jayheiland/CE_Senior_Project/schematics/HIGH_PASS_ACRYLLIC.pdf

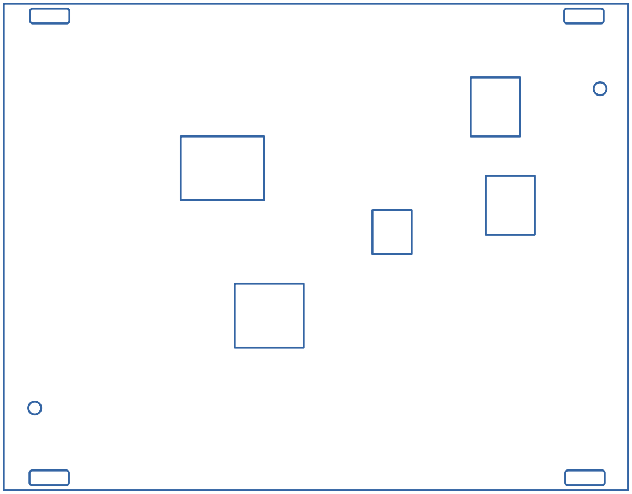
[picture p20: figure]
