jayheiland/CE_Senior_Project/schematics/PCB_ACRYLLIC.pdf

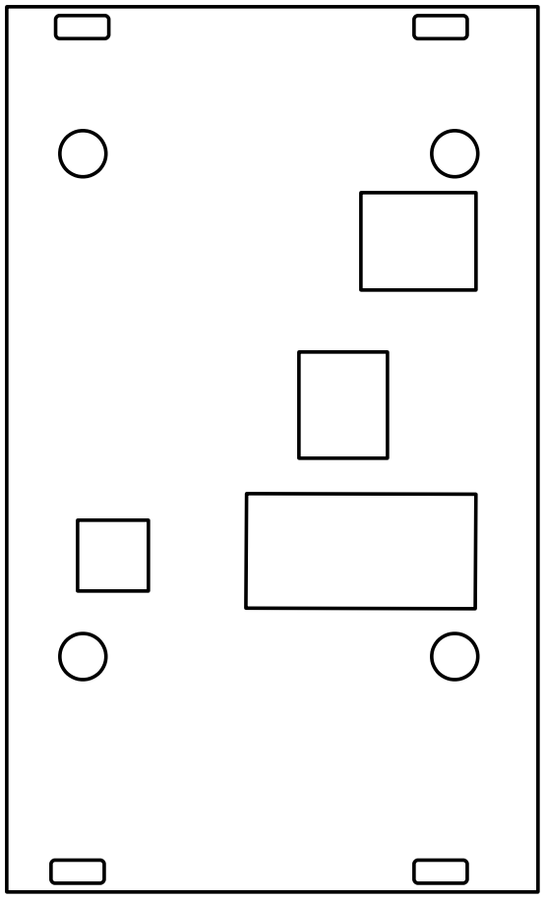
[picture p21: figure]
