jayheiland/CE_Senior_Project/docs/spring 2019 docs/IMG_0136.jpg

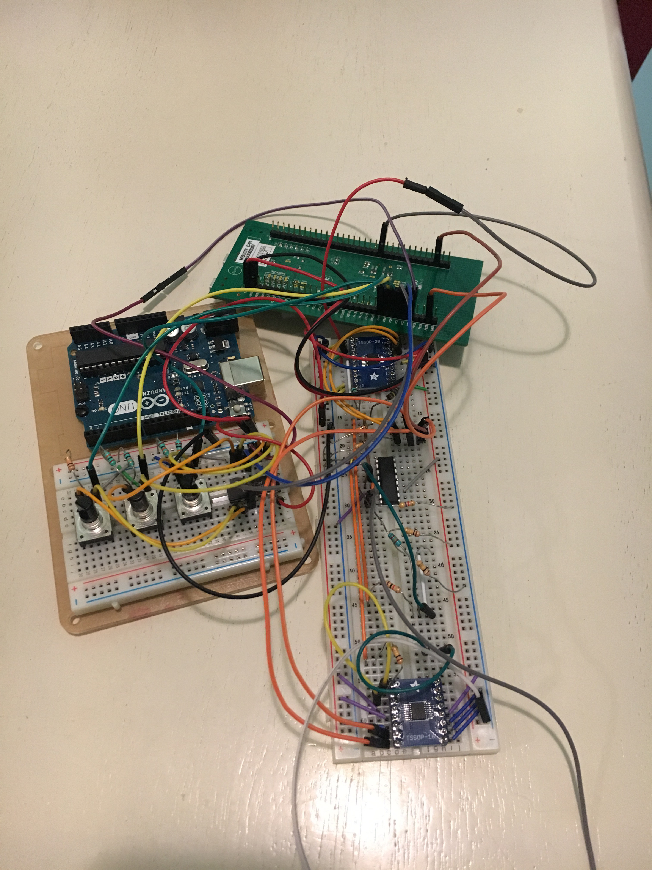
docs/spring 2019 docs/IMG_0136.jpg
