jayheiland/CE_Senior_Project/docs/spring 2019 docs/schematic.PNG

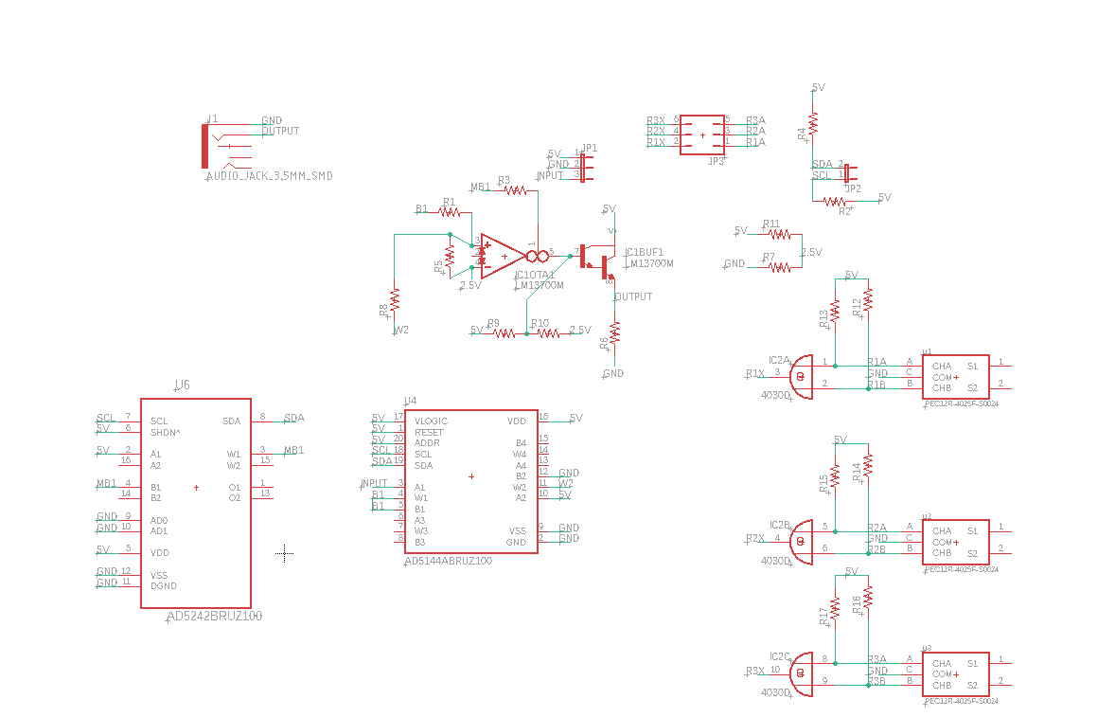
docs/spring 2019 docs/schematic.PNG
