jayheiland/CE_Senior_Project/docs/spring 2019 docs/triangleToSine.png

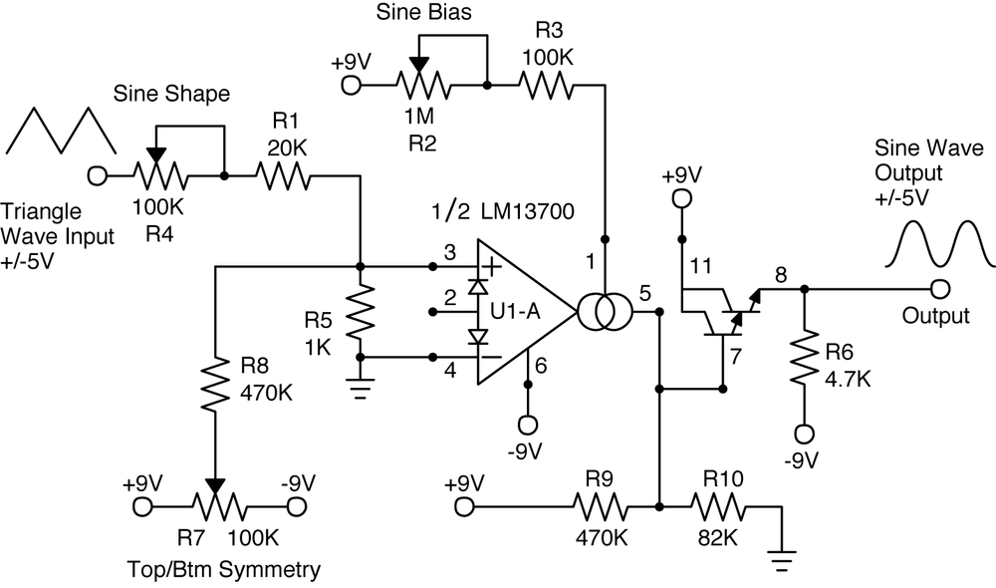
docs/spring 2019 docs/triangleToSine.png
