jayheiland/CE_Senior_Project/app src/todo.txt

To-do:

Sliders in GUI
Test if the serial error is a constant problem, or if it can be fixed by resetting the STM
reduce read timer time
try removing the update modules sleep

usage note: .cancel read_timer before calling restart_read_timer
