jayheiland/CE_Senior_Project/docs/spring 2019 docs/Board.pdf

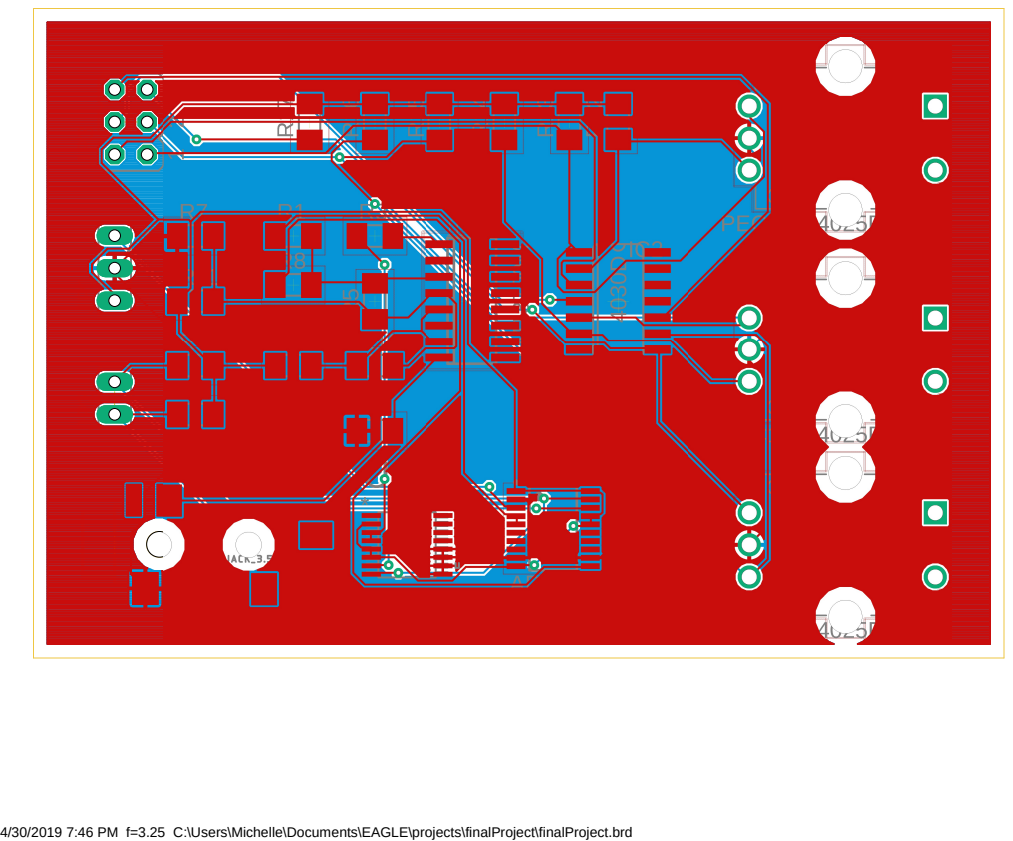
[picture p25: page 1]
PEC12R-4025F-S0024

4/30/2019 7:46 PM f=3.25 C:\Users\Michelle\Documents\EAGLE\projects\finalProject\finalProject.brd
