jayheiland/CE_Senior_Project/schematics/VCO.brd

## EAGLE design schematics/VCO.brd (2020-01-23)

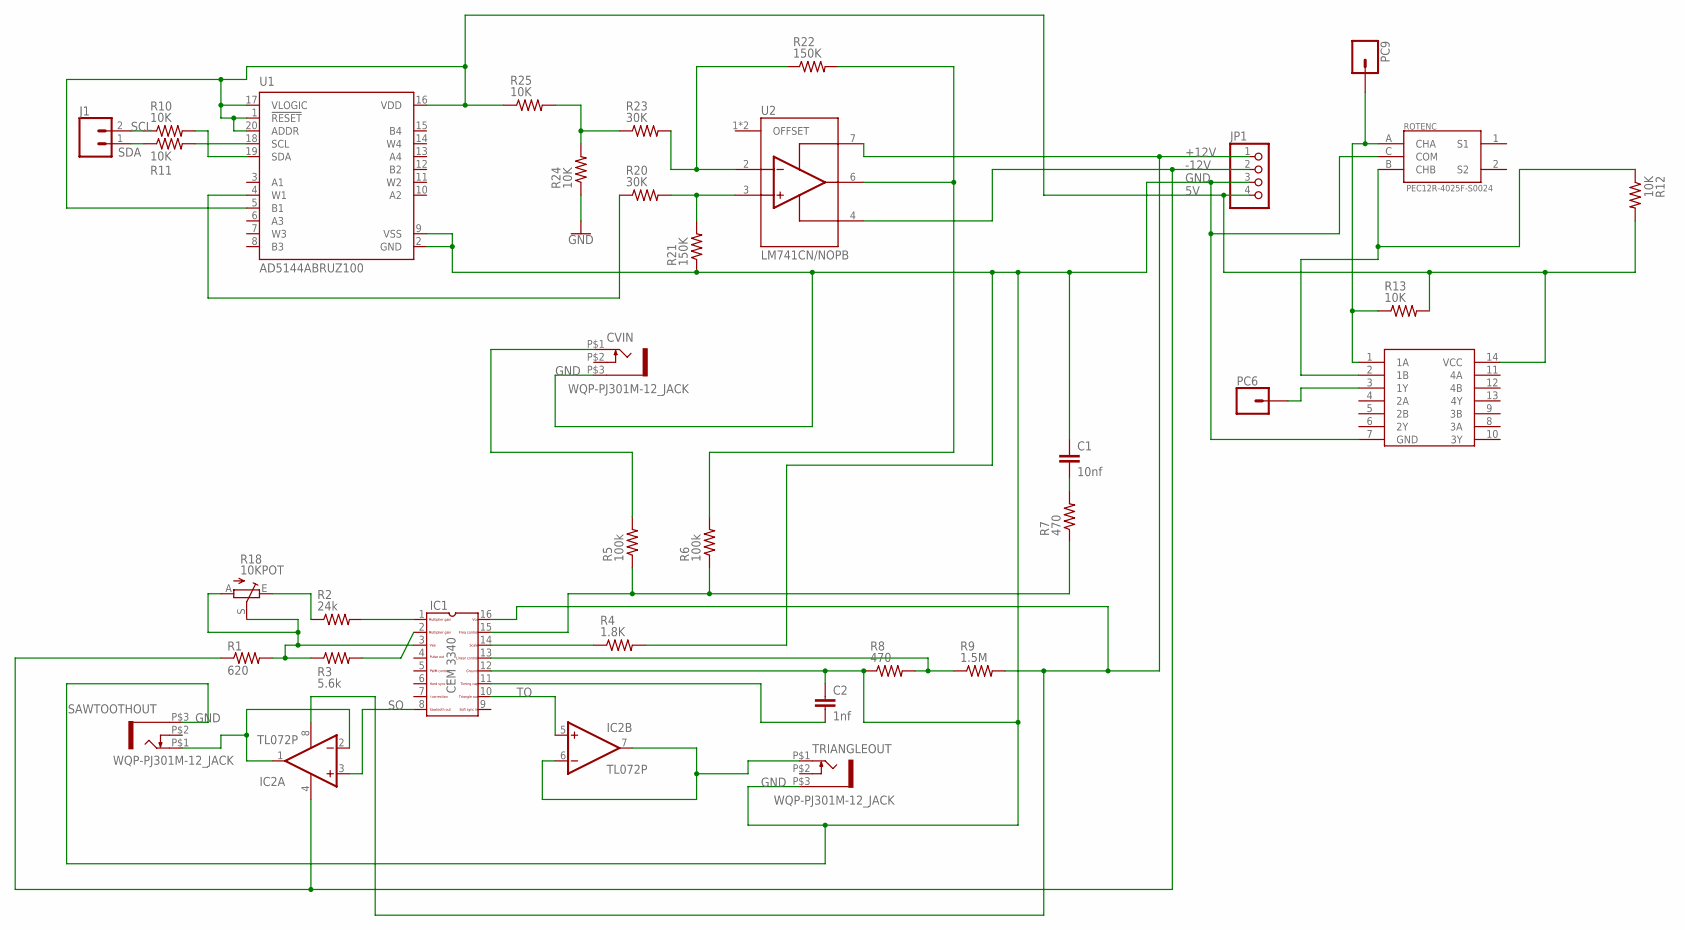
[picture p26: schematic VCO.sch]

Parts:
C1: 10nf; C2.5-3
C2: 1nf; C2.5-3
CVIN: WQP-PJ301M-12_JACK
IC1: CEM3340; DIL16
IC2: TL072P; DIL08
J1: CONN_02; 1X02
JP1: PINHD-1X4; 1X04
PC6, PC9: CONN_01; 1X01
R1: 620; 0207/10
R2: 24k; 0207/10
R3: 5.6k; 0207/10
R4: 1.8K; 0207/10
R5, R6: 100k; 0207/10
R7, R8: 470; 0207/10
R9: 1.5M; 0207/10
R10, R11, R12, R13, R24, R25: 10K; 0207/10
R18: 10KPOT; B25P
R20, R23: 30K; 0207/10
R21, R22: 150K; 0207/10
ROTENC: PEC12R-4025F-S0024; ENC_PEC12R-4025F-S0024
SAWTOOTHOUT: WQP-PJ301M-12_JACK
TRIANGLEOUT: WQP-PJ301M-12_JACK
U1: AD5144ABRUZ100; SOP65P640X120-20N
U2: LM741CN/NOPB; DIP794W45P254L1016H508Q8
XOR: SN54HC86; DIP762W51P254L1994H508Q14

Connections:
5V: JP1.4, R12.2, R13.2, R25.1, U1.1 (!RESET), U1.5 (B1), U1.16 (VDD), U1.17 (VLOGIC), U1.20 (ADDR), XOR.14 (VCC)
+12V: IC1.16, IC2.8 (V+), JP1.1, R9.2, U2.7 (V+)
-12V: IC2.4 (V-), JP1.2, R1.1, U2.4 (V-)
GND: C1.1, C2.1, CVIN.P$3 (1), IC1.12, JP1.3, R4.2, R8.1, R21.1, R24.1, ROTENC.C (COM), SAWTOOTHOUT.P$3 (1), TRIANGLEOUT.P$3 (1), U1.2 (GND), U1.9 (VSS), XOR.7 (GND)
unnamed: IC1.1, R2.2
unnamed: IC1.2, R3.2
unnamed: IC1.3, R1.2, R3.1, R18.A, R18.S
unnamed: PC9.1, R13.1, ROTENC.A (CHA), XOR.1 (1A)
unnamed: R12.1, ROTENC.B (CHB), XOR.2 (1B)
unnamed: IC1.14, R4.1
unnamed: IC1.15, R5.1, R6.1, R7.1
unnamed: R6.2, R22.2, U2.6 (OUTPUT)
unnamed: CVIN.P$1 (2), R5.2
unnamed: C1.2, R7.2
unnamed: IC2.6 (-IN), IC2.7 (OUT), TRIANGLEOUT.P$1 (2)
unnamed: IC1.13, R8.2, R9.1
unnamed: C2.2, IC1.11
unnamed: IC2.1 (OUT), IC2.2 (-IN), SAWTOOTHOUT.P$1 (2)
unnamed: R2.1, R18.E
unnamed: R11.2, U1.18 (SCL)
unnamed: R20.2, R21.2, U2.3 (NON-INV_INPUT)
unnamed: R22.1, R23.2, U2.2 (INV_INPUT)
unnamed: R23.1, R24.2, R25.2
unnamed: R20.1, U1.4 (W1)
unnamed: R10.2, U1.19 (SDA)
unnamed: PC6.1, XOR.3 (1Y)
SCL: J1.2, R10.1
SDA: J1.1, R11.1
SO: IC1.8, IC2.3 (+IN)
TO: IC1.10, IC2.5 (+IN)

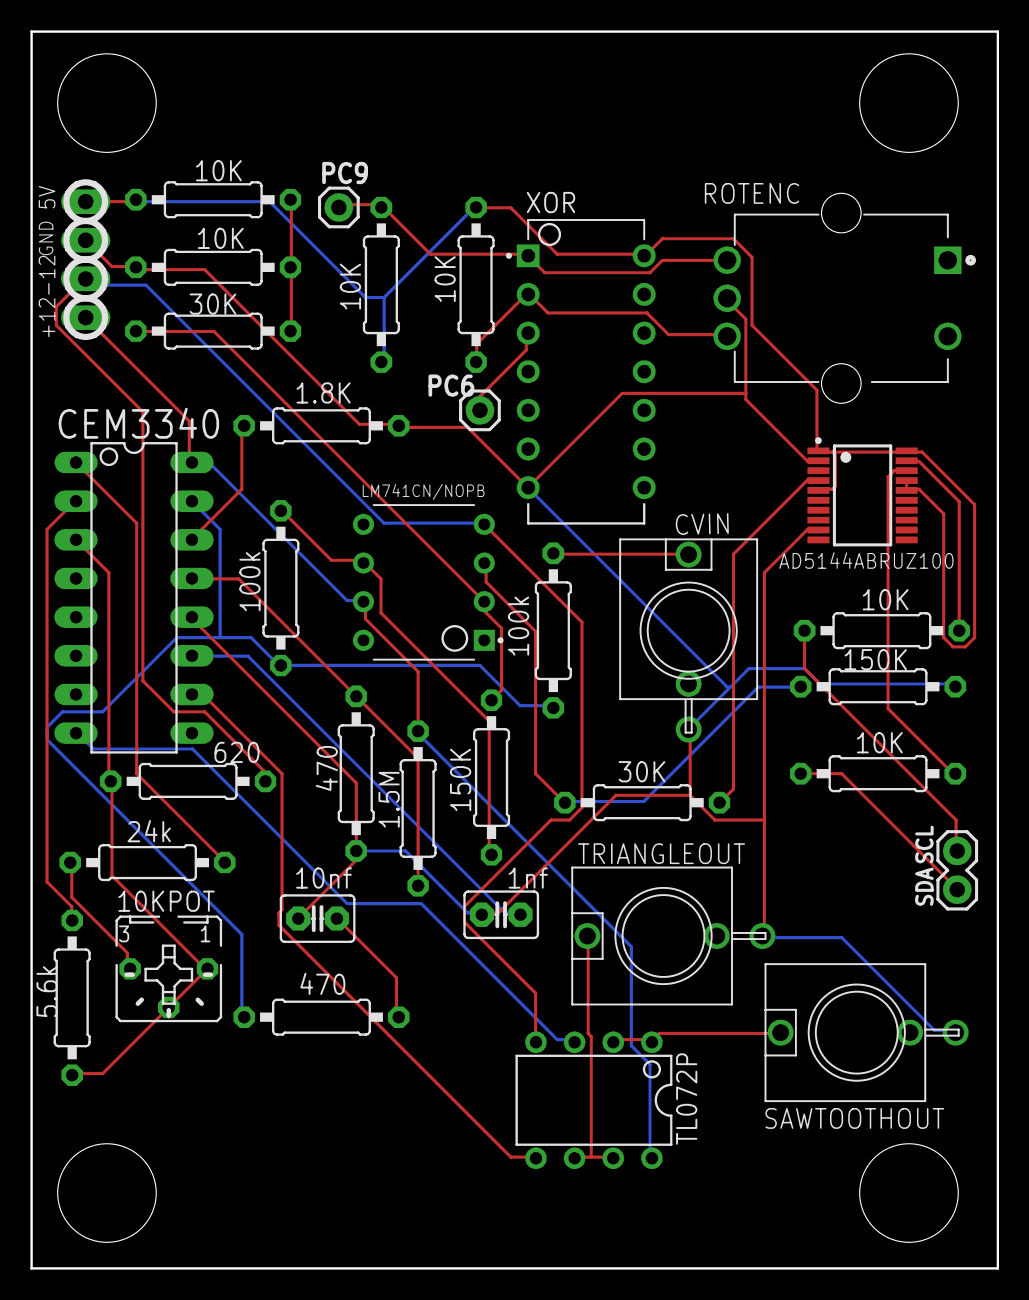
[picture p27: board VCO.brd from above]

Board: 2 copper layers, 63.5 x 81.3 mm, 35 parts (0 on the bottom side), 30 nets.
