jayheiland/CE_Senior_Project/embedded src/Src/main.c

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

/* Includes ------------------------------------------------------------------*/
#include "main.h"
#include "helper.h"


void SystemClock_Config(void);
/* USER CODE END 0 */
static volatile char USART_INPUT;
static volatile char USART_READY = 0;

static volatile uint8_t res_1_val = 0x00;	// VCO pot: tunes pitch register
static volatile uint8_t res_5_val = 0x00; // Low-pass VCF pot: determines cutoff frequency
static volatile uint8_t res_6_val = 0x00;	// High-pass VCF pot: determines cutoff frequency
static volatile int ENCODER_FLAG = 0;

/**
  * @brief  The application entry point.
  * @retval int
  */
int main(void)
{
  /* MCU Configuration--------------------------------------------------------*/

  /* Reset of all peripherals, Initializes the Flash interface and the Systick. */
  HAL_Init();

  /* Configure the system clock */
  SystemClock_Config();

 	I2C_setup();
	USART_setup();
	encoder_setup();
	

	// first quad 100k digipot (1) addr: 0101000 = 0x28
	// second quad 100k digipot (5 & 6) addr: 0101010 = 0x2A
	// RDACy = 000100xx = 0x1y
	send_string("setup complete\n");

	// digipot basic test
	// write initial values
	digipot_write(1, res_1_val);
	digipot_write(5, res_5_val);
	digipot_write(6, res_6_val);
		
	send_string("wrote 0x80 to RDAC1\n");
		
	uint8_t value_1 = digipot_read(1);
	uint8_t value_5 = digipot_read(5);
	uint8_t value_6 = digipot_read(6);
		
	if (value_1 == res_1_val && value_5 == res_5_val && value_6 == res_6_val) {
		send_string("Self test passed\n");
	}
	else {
		send_string("Self test failed\n");
	}
	


  /* Infinite loop */
  /* USER CODE BEGIN WHILE */
  while (1)
  {	
    //Digipot control loop
		send_string("\nResistor?\n");

		while(USART_READY == 0) {}
		USART_READY = 0;
		
		char res_num_char = USART_INPUT;
		send_char(res_num_char);
		if (res_num_char == 'r' || res_num_char == 'R') {
			send_string("res_1_val: ");
			send_char(hex_to_char((res_1_val & 0xF0) >> 4));
			send_char(hex_to_char(res_1_val & 0xF));
			send_char('\n');
			send_string("res_5_val: ");
			send_char(hex_to_char(res_5_val >> 4));
			send_char(hex_to_char(res_5_val & 0xF));
			send_char('\n');
			send_string("res_6_val: ");
			send_char(hex_to_char(res_6_val >> 4));
			send_char(hex_to_char(res_6_val & 0xF));
			send_char('\n');
		}
		else {
			uint8_t res_num = char_to_hex(res_num_char);
			
			send_string("\nValue MSN?\n");

			while(USART_READY == 0) {}
			USART_READY = 0;
			
			char res_value_MSN = USART_INPUT;
			send_char(res_value_MSN);
			send_char('\n');
				
			send_string("\nValue LSN?\n");

			while(USART_READY == 0) {}
			USART_READY = 0;
			
			char res_value_LSN = USART_INPUT;
			send_char(res_value_LSN);
			
			uint8_t res_value = (char_to_hex(res_value_MSN) << 4) | char_to_hex(res_value_LSN);
				
			digipot_write(res_num, res_value);
			switch (res_num) {
				case 1:
					res_1_val = res_value;
					break;
				case 5:
					res_5_val = res_value;
					break;
				case 6:
					res_6_val = res_value;
					break;
			}
		}
		if (ENCODER_FLAG) {
			send_string("updating");
			digipot_write(1, res_1_val);
			digipot_write(5, res_5_val);
			digipot_write(6, res_6_val);
			ENCODER_FLAG = 0;
		}
	}
}

void USART3_4_IRQHandler(void)
{
	USART_INPUT = USART3->RDR;
	USART_READY = 1;
}

// Quadrature Encoder Matrix
const int QEM [16] = {0, -1, 1, 2, 1, 0, 2, -1, -1, 2, 0, 1, 2, 1, -1, 0}; 
static volatile int old_enc_1 = 0;
static volatile int old_enc_5 = 0;
static volatile int old_enc_6 = 0;




void EXTI4_15_IRQHandler(void) 
{
	if (EXTI->PR & EXTI_PR_PIF6) {
		int enc_1_A = GPIOC->IDR & GPIO_IDR_9;
		int enc_1_B = enc_1_A ^ (GPIOC->IDR & GPIO_IDR_6);
		int new_enc_1 = (enc_1_A << 1) | enc_1_B;	
		int res_1_change = QEM[(old_enc_1 * 4) + new_enc_1];
		
		if (res_1_val == 0x0 && res_1_change < 0) { }
		else if (res_1_val == 0xFF && res_1_change > 0) { }
		else if (res_1_change == 2) {send_string("enc_1_error\n");}
		else {
			res_1_val += res_1_change;
		}
		
		old_enc_1 = new_enc_1;
				
		//Clear the interrupt flag to indicate it has been handled
		EXTI->PR |= EXTI_PR_PIF6;
	}
	else if (EXTI->PR & EXTI_PR_PIF7) {
		int enc_5_A = GPIOA->IDR & GPIO_IDR_8;
		int enc_5_B = enc_5_A ^ (GPIOC->IDR & GPIO_IDR_7);
		int new_enc_5 = (enc_5_A << 1) | enc_5_B;	
		int res_5_change = QEM[(old_enc_5 * 4) + new_enc_5];
		
		if (res_5_val == 0x0 && res_5_change < 0) { }
		else if (res_5_val == 0xFF && res_5_change > 0) { }
		else if (res_5_change == 2) {send_string("enc_5_error\n");}
		else {
			res_5_val += res_5_change;
		}
		
		old_enc_5 = new_enc_5;
		
		//Clear the interrupt flag to indicate it has been handled
		EXTI->PR |= EXTI_PR_PIF7;
	}
	else if (EXTI->PR & EXTI_PR_PIF8) {
		int enc_6_A = GPIOA->IDR & GPIO_IDR_9;
		int enc_6_B = enc_6_A ^ (GPIOC->IDR & GPIO_IDR_8);
		int new_enc_6 = (enc_6_A << 1) | enc_6_B;	
		int res_6_change = QEM[(old_enc_6 * 4) + new_enc_6];
		
		if (res_6_val == 0x0 && res_6_change < 0) { }
		else if (res_6_val == 0xFF && res_6_change > 0) { }
		else if (res_6_change == 2) {send_string("enc_6_error\n");}

		else {
			res_6_val += res_6_change / 10;
		}
		
		old_enc_6 = new_enc_6;
		
		//Clear the interrupt flag to indicate it has been handled
		EXTI->PR |= EXTI_PR_PIF8;
	}
	ENCODER_FLAG = 1;
}

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
