jayheiland/CE_Senior_Project/(commit log)

2019-05-01 Add prototype documentation
2019-10-17 Add modules GUI, improve save/load functionality
    Now opens save/load dialogs when clicking Save or Load buttons
2019-12-05 Add new resistor indexes for high pass/low pass filters
2019-12-06 Add switching/closing preset pips functionality
2019-12-14 embedded C code for digipot & rotary encoder, USART
2020-01-23 Reorganize project folders, add source files for final report and supporting components
    [Project8_1.cfg, VCO.brd, VCO.sch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]
2020-01-23 Remove embedded drivers, libs, extraneous files
